UserIsMissing/Wet-Dry-Cycler/(list of files, cad)

Other CAD files:
pcb/pcb.gcode.3mf
pcb_v2/pcb/pcb.gcode.3mf
