UserIsMissing/Wet-Dry-Cycler/Cycletron/src/MOVEMENT.cpp

/**
 * @file    MOVEMENT.cpp
 * @brief   Movement module for stepper navigation using DRV8825 driver
 *
 * This module controls stepper motor movement across subsystems (e.g., heating,
 * mixing, extraction). It includes bumper detection, safe startup handling,
 * and DRV8825 stepper driver integration.
 *
 * Author: Cole Schreiner/Rafael Delwart
 * Date:   14 Apr 2025 adapted for ESP 13 May 2025
 */

#include <Arduino.h>
#include "MOVEMENT.h"
#include "globals.h"
#include "send_functions.h"


// === Constants ===
#define MOVEMENT_STEP_DELAY_US 1000 // Delay between microsteps
#define MOVEMENT_MAX_STEPS 10000 // Set your safety threshold here // needs to be found and changed

// === Global State ===
volatile bool movementFrontTriggered = false;
volatile bool movementBackTriggered = false;

// === Motor and Sensor Config ===
DRV8825_t movementMotor = {
    .step_pin = 6,
    .dir_pin = 7,
    .fault_pin = 15,
    .mode0_pin = 16,
    .mode1_pin = 17,
    .mode2_pin = 18,
    .enable_pin = 8};

BUMPER_t bumpers_m = {
    .front_bumper_pin = 3,
    .back_bumper_pin = 10,
};

enum MovementInitState {
  INIT_IDLE,
  INIT_MOVING_BACK,
  INIT_DONE
};

MovementInitState movementInitState = INIT_IDLE;

/**
 * @brief Initializes the movement motor and immediately disables it.
 *
 * Use this to ensure the motor is set up but not powered.
 *
 * .
 */
void MOVEMENT_InitAndDisable()
{
  DRV8825_Init(&movementMotor);
  Serial.println("[MOVEMENT] Motor initialized and disabled.");
}

/**
 * @brief Initializes the MOVEMENT system.
 *
 * Calibrates motor direction using bumper input and prepares the system
 * for safe directional control. It attempts to find the front bumper
 * and align to it before stopping.
 */
void MOVEMENT_Init()
{
    delay(500); // Delay for system stability

    DRV8825_Init(&movementMotor); // Initialize motor driver
    CheckBumpers();               // Read initial bumper state

    Serial.printf("Initial BUMPER_STATE: %d\n", BUMPER_STATE);

    // Ensure no movement if the back bumper is already pressed
    if (digitalRead(bumpers_m.back_bumper_pin) == HIGH)
    {
        Serial.println("[MOVEMENT] Back bumper already pressed. No movement required.");
        DRV8825_Disable(&movementMotor);
    }
    else
    {
        while (BUMPER_STATE != 2)
        {
            DRV8825_Move(&movementMotor, 1, DRV8825_BACKWARD, MOVEMENT_STEP_DELAY_US);
            CheckBumpers();
            
            // Yield control every few steps to prevent WebSocket timeouts during init
            static int initStepCount = 0;
            if (++initStepCount >= 10) {
              initStepCount = 0;
              yield(); // Allow WiFi/WebSocket processing
            }
        }
        DRV8825_Disable(&movementMotor);
    }

    Serial.println("[MOVEMENT] Initialization complete.");
}

/**
 * @brief Reads bumper interrupt flags and updates global BUMPER_STATE.
 * Now includes software debouncing to prevent false triggers.
 *
 * @return 1 = front bumper triggered, 2 = back bumper triggered, 0 = none
 */
int CheckBumpers()
{
  static unsigned long lastFrontTriggerTime = 0;
  static unsigned long lastBackTriggerTime = 0;
  unsigned long now = millis();
  
  if (movementFrontTriggered)
  {
    // Software debouncing: ignore triggers within 50ms of last trigger
    if (now - lastFrontTriggerTime > 50) {
      movementFrontTriggered = false; // Reset flag
      lastFrontTriggerTime = now;
      BUMPER_STATE = 1;
      Serial.println("[MOVEMENT] Front bumper triggered.");
      return 1;
    } else {
      movementFrontTriggered = false; // Reset flag but ignore trigger
    }
  }
  if (movementBackTriggered)
  {
    // Software debouncing: ignore triggers within 50ms of last trigger
    if (now - lastBackTriggerTime > 50) {
      movementBackTriggered = false; // Reset flag
      lastBackTriggerTime = now;
      BUMPER_STATE = 2;
      Serial.println("[MOVEMENT] Back bumper triggered.");
      return 2;
    } else {
      movementBackTriggered = false; // Reset flag but ignore trigger
    }
  }
  BUMPER_STATE = 0;
  return 0;
}

/**
 * @brief Moves motor based on bumper state.
 *
 * If front bumper is pressed, move backward until back is pressed.
 * If back bumper is pressed, move forward until front is pressed.
 * Movement stops immediately if target bumper is hit.
 * Updated to yield control for WebSocket stability.
 */
void MOVEMENT_Move_FORWARD()
{
  DRV8825_Set_Step_Mode(&movementMotor, DRV8825_FULL_STEP);
  CheckBumpers();
  int stepCount = 0;
  while (BUMPER_STATE != 1)
  {
    DRV8825_Move(&movementMotor, 1, DRV8825_FORWARD, MOVEMENT_STEP_DELAY_US);
    CheckBumpers();
    stepCount++;
    if (stepCount > MOVEMENT_MAX_STEPS) {
      MOVEMENT_Stop();
      currentState = SystemState::ERROR;
      sendSystemError(ERROR_MOVEMENT_MAX_STEPS_FORWARD);
      return;
    }
  }
  MOVEMENT_Stop();
}

void MOVEMENT_Move_BACKWARD()
{
  DRV8825_Set_Step_Mode(&movementMotor, DRV8825_FULL_STEP);
  CheckBumpers();
  int stepCount = 0;
  while (BUMPER_STATE != 2)
  {
    DRV8825_Move(&movementMotor, 1, DRV8825_BACKWARD, MOVEMENT_STEP_DELAY_US);
    CheckBumpers();
    stepCount++;
    if (stepCount > MOVEMENT_MAX_STEPS) {
      MOVEMENT_Stop();
      currentState = SystemState::ERROR;
      sendSystemError(ERROR_MOVEMENT_MAX_STEPS_BACKWARD);
      return;
    }
  }
  MOVEMENT_Stop();
}

/**
 * @brief Stops the motor by setting step pin LOW.
 */
void MOVEMENT_Stop()
{
  digitalWrite(movementMotor.step_pin, LOW);
  DRV8825_Disable(&movementMotor);
  Serial.println("[MOVEMENT] Motor stopped.");
}

/**
 * @brief Interrupt handler for front bumper trigger.
 *
 * Sets the global movementFrontTriggered flag to true.
 * Keep minimal to avoid watchdog resets and WebSocket issues.
 */
void IRAM_ATTR onMovementFrontLimit()
{
  movementFrontTriggered = true;
}

/**
 * @brief Interrupt handler for back bumper trigger.
 *
 * Sets a flag indicating the back bumper has been triggered.
 * Keep minimal to avoid watchdog resets and WebSocket issues.
 */
void IRAM_ATTR onMovementBackLimit()
{
  movementBackTriggered = true;
}

/**
 * @brief Configures GPIO pins for bumpers and sets up interrupts.
 *
 * Sets the front and back bumper pins as INPUT_PULLUP and attaches
 * interrupt handlers for both bumpers.
 *
 * Note: This version skips `detachInterrupt()` to avoid crashing if
 * the ISR service hasn't been initialized yet. It only attaches if
 * the pin is HIGH (i.e., unpressed).
 */
void MOVEMENT_ConfigureInterrupts()
{
  pinMode(bumpers_m.front_bumper_pin, INPUT_PULLDOWN);
  pinMode(bumpers_m.back_bumper_pin, INPUT_PULLDOWN);

  movementFrontTriggered = false;
  movementBackTriggered = false;

  attachInterrupt(digitalPinToInterrupt(bumpers_m.front_bumper_pin), onMovementFrontLimit, RISING);
  attachInterrupt(digitalPinToInterrupt(bumpers_m.back_bumper_pin), onMovementBackLimit, RISING);
}
/**
 * @brief Handles interrupts for front and back bumpers.
 *
 * Simplified version that just checks flags without detaching/reattaching interrupts
 * to prevent WebSocket timing issues.
 */
void MOVEMENT_HandleInterrupts()
{
  // The actual interrupt handling is now done in CheckBumpers() 
  // which provides software debouncing and is called from main loop
  // This function is kept for compatibility but could be removed
}
