UserIsMissing/Wet-Dry-Cycler/Cycletron/src/MIXING.cpp

/**
 * @file    MIXING.cpp
 * @brief   DC Motor control module using GPIO pins (Arduino/ESP32 compatible).
 *
 * Provides initialization and control functions for mixing motors.
 *
 * @author  Rafael Delwart
 * @date    25 Feb 2025 adapted for ESP 13 May 2025
 */

 #include <Arduino.h>
 #include "MIXING.h"
 

//  #define TESTING_MIXING

 // === CONFIG ===
 #define MIX1_GPIO 11
 #define MIX2_GPIO 12
 #define MIX3_GPIO 13  
 
 // Define motor GPIOs in an array for batch operations
 static const uint8_t motorPins[] = {MIX1_GPIO, MIX2_GPIO, MIX3_GPIO};
 static const int NUM_MOTORS = sizeof(motorPins) / sizeof(motorPins[0]);
 
 // === API IMPLEMENTATION ===
 
 /**
  * @brief Initializes all mixing motor GPIOs as OUTPUT and sets them LOW.
  */
 void MIXING_Init() {
   for (int i = 0; i < NUM_MOTORS; i++) {
     pinMode(motorPins[i], OUTPUT);
     digitalWrite(motorPins[i], LOW);  // Motors off by default
   }
   Serial.println("[MIXING] All motors initialized and set to OFF");
 }
 
 /**
  * @brief Turns ON the motor connected to the given GPIO pin.
  * @param pin GPIO pin number
  */
 void MIXING_Motor_OnPin(uint8_t pin) {
   digitalWrite(pin, HIGH);
 }
 
 /**
  * @brief Turns OFF the motor connected to the given GPIO pin.
  * @param pin GPIO pin number
  */
 void MIXING_Motor_OffPin(uint8_t pin) {
   digitalWrite(pin, LOW);
 }
 
 /**
  * @brief Turns ON all defined motors.
  */
 void MIXING_AllMotors_On() {
   for (int i = 0; i < NUM_MOTORS; i++) {
     digitalWrite(motorPins[i], HIGH);
   }
 }
 
 /**
  * @brief Turns OFF all defined motors.
  */
 void MIXING_AllMotors_Off() {
   for (int i = 0; i < NUM_MOTORS; i++) {
     digitalWrite(motorPins[i], LOW);
   }
 }

// === TEST LOOP ===
// This section is for testing the mixing motors.
#ifdef TESTING_MIXING

void setup() {
  Serial.begin(115200);
  MIXING_Init();
}

void loop() {
  // Step through each motor
  for (int i = 0; i < NUM_MOTORS; i++) {
    Serial.printf("[TEST] Turning ON motor %d (GPIO %d)\n", i + 1, motorPins[i]);
    MIXING_Motor_OnPin(motorPins[i]);
    delay(10000); // ON for 10 seconds

    Serial.printf("[TEST] Turning OFF motor %d (GPIO %d)\n", i + 1, motorPins[i]);
    MIXING_Motor_OffPin(motorPins[i]);
    delay(3000);  // OFF for 3 seconds
  }

  // All motors ON
  Serial.println("[TEST] Turning ALL motors ON");
  MIXING_AllMotors_On();
  delay(20000);

  // All motors OFF
  Serial.println("[TEST] Turning ALL motors OFF");
  MIXING_AllMotors_Off();
  delay(5000);
}

#endif // TESTING_MIXING
