UserIsMissing/Wet-Dry-Cycler/Cycletron/src/REHYDRATION.h

/**
 * @file    REHYDRATION.h
 * @brief   Syringe pump control interface for RNA fluid rehydration
 *
 * This header declares the control functions for a stepper motor
 * used to precisely dispense and retract fluid via a syringe pump.
 * It uses a DRV8825 stepper motor driver to move the plunger and
 * convert microliter requests into accurate step commands.
 *
 * Designed for use in wet-dry cycling systems for RNA research.
 *
 * Author: Rafael Delwart
 * Date:   20 Apr 2025 adapted for ESP 13 May 2025
 */

#ifndef REHYDRATION_H
#define REHYDRATION_H

#include <Arduino.h>
#include "DRV8825.h"

// === Global State Flag ===
/**
 * @brief Global variable indicating bumper contact:
 * - 0 = no bumper pressed
 * - 1 = front bumper pressed
 * - 2 = back bumper pressed
 */
extern int BUMPER_STATE;
// === SYRINGE PUMP Max Steps ===
#define MAX_SYRINGE_STEPS 159251  // or a more realistic value based on your hardware


// === Syringe & Motion Parameters ===
#define STEPPER_STEPS_PER_REV 200 // Full steps per revolution of stepper motor
#define MICROSTEPPING 16          // Microstepping mode (e.g., 1/16 step)
#define LEADSCREW_TPI 20          // Threads per inch of leadscrew
#define SYRINGE_DIAMETER_IN 1.0   // Syringe barrel inner diameter in inches

// === Conversion Factors ===
#define TOTAL_STEPS_PER_REV (STEPPER_STEPS_PER_REV * MICROSTEPPING)
#define LEADSCREW_TRAVEL_IN_PER_REV (1.0 / LEADSCREW_TPI)
#define STEP_TRAVEL_IN (LEADSCREW_TRAVEL_IN_PER_REV / TOTAL_STEPS_PER_REV)
#define INCH3_TO_UL 16387.064 // Conversion factor from in³ to microliters

/**
 * @brief Calculates how many microliters are moved per motor step.
 *
 * This function computes the volume displaced by one step of the leadscrew-driven
 * syringe pump based on the cross-sectional area of the syringe and the travel
 * distance per motor step.
 *
 * @param syringeDiameterInches Inner diameter of the syringe barrel (in inches).
 * @return Volume in microliters (µL) moved by one motor step.
 */
float calculate_uL_per_step(float syringeDiameterInches);


/**
 * @brief Initializes the syringe pump motor and immediately disables it.
 *
 * Use this to ensure the motor is set up but not powered.
 *
 * @param syringeDiameterInches Syringe inner diameter in inches.
 */
void Rehydration_InitAndDisable();


/**
 * @brief Initializes the syringe pump stepper motor.
 *
 * This sets up the DRV8825 driver pins, applies the default microstepping mode,
 * and prints calibration data including the volume of fluid dispensed per motor step.
 * Call this once during system setup.
 *
 * @param syringeDiameterInches Syringe diameter in inches (e.g., 0.25 for 1/4 inch)
 */
void Rehydration_Init(float syringeDiameterInches);

/**
 * @brief Dispenses a specific volume of liquid in microliters by pushing the plunger forward.
 *
 * Converts the desired microliters to motor steps based on syringe and leadscrew dimensions,
 * and moves the motor forward (push) at a controlled speed to ensure accurate fluid delivery.
 *
 * @param uL Volume of fluid to dispense, in microliters.
 * @param syringeDiameterInches Syringe diameter in inches (e.g., 0.25 for 1/4 inch)
 */
void Rehydration_Push(uint32_t uL, float syringeDiameterInches);

/**
 * @brief Retracts the syringe plunger to draw fluid or prime the system.
 *
 * Similar to Rehydration_Push(), but moves in reverse to create suction.
 * Useful for loading liquid into the syringe or preparing it for operation.
 *
 * @param uL Volume of fluid to draw back, in microliters.
 * @param syringeDiameterInches Syringe diameter in inches (e.g., 0.25 for 1/4 inch)
 */
void Rehydration_Pull(uint32_t uL, float syringeDiameterInches);

/**
 * @brief Disables the stepper motor to stop motion and reduce power consumption.
 *
 * This function cuts power to the DRV8825 driver, halting the motor and preventing
 * unnecessary heating or energy drain. It should be called after movement is complete.
 */
void Rehydration_Stop();

// BUMPER HANDLING

/**
 * @brief Interrupt handler for front bumper trigger.
 *
 * Sets a flag indicating the front bumper has been triggered.
 */
void IRAM_ATTR onRehydrationFrontLimit();
/**
 * @brief Interrupt handler for back bumper trigger.
 *
 * Sets a flag indicating the back bumper has been triggered.
 */
void IRAM_ATTR onRehydrationBackLimit();

/**
 * @brief Configures GPIO pins for front and back bumpers.
 *
 * Sets the specified pins as input with pull-up resistors and attaches
 * interrupt handlers for detecting bumper presses.
 *
 */
void REHYDRATION_ConfigureInterrupts();
/**
 * @brief Handles interrupts for front and back bumpers.
 *
 * Handles the state of the bumpers and stops the rehydration process
 * if either bumper is triggered. This function should be called in the
 * main loop to check for bumper events.
 *
 */

void REHYDRATION_HandleInterrupts();


/**
 * @brief Moves backward until the back bumper is hit.
 */
void Rehydration_BackUntilBumper();


int R_CheckBumpers();



/**
 * @brief Performs calibration test to measure syringe travel range
 * @return Total number of 1/16th steps between bumpers
 */
uint32_t Rehydration_CalibrationTest();


#endif // REHYDRATION_H
