UserIsMissing/Wet-Dry-Cycler/(commit log)

2025-01-23 Stepper Motor running at half steps using the ECE167 library for the STM32
2025-02-20 Fixing Heating Module
2025-02-25 Initial heating module finished, test still need to be made
2025-02-27 Adding Pin details and renaming pins
2025-03-02 Update MIXING.c pin identifier
2025-03-02 Update HEATING.c pin identifier
2025-03-16 Cleaned Up Mixing Code, and Changed heating to work with voltage divider IC
2025-04-09 testing stepper driver using pwms
2025-04-11 Added Rehydration_DRV8825 code(can be copied and pins changed for movement system aswell.) Also changed GPIO h/c to add more gpio pins for the DRV8825 control. Motor uses 6 gpios.
2025-04-11 Updated DRV8825 Library to be universal and work with multiple motors, tested code and other small changes everything appears to work(still need to test fault line)
2025-04-17 cant printf
2025-04-20 Added an enable pin to the DRV8825 code in order to stop current draw when the motor isnt moving. Added for DRV example coded aswell as the Movement library
2025-04-20 Changed the heating system to use the BETA method instead, far more reliable and accurate. Seems to work great!
2025-04-22 Enable pin working. going to add ISR now for bumpers
2025-04-23 fixed syntax. need to test ISR
    [MOVEMENT.h]
2025-04-23 changed syringe diameter
2025-04-23 Changed mixing/heating pins and updated some code
2025-04-23 Fixing mixing pins and heatings pins
    [MIXING.h]
2025-04-23 Fixing merge issues and GPIO file problems
    [HEATING.h]
2025-04-24 fixed state machine? still working on ISR testing
    [Board.c]
2025-04-24 ISR WORKS! needed to add // Add manual fallback EXTI->FTSR |= GPIO_PIN_8; // Ensure falling edge is enabled to board.c
2025-06-04 Merging Cole And Rafael Branches to main
    [12V Power Supply.kicad_sch, BOM.csv, Heating_controller.kicad_sch, Regulator.kicad_sch, VoltageDivider.kicad_sch, Wet_Dry Cycling.kicad_pcb, Wet_Dry Cycling.kicad_sch, mixing_control.kicad_sch]
2025-06-04 fixing accidentaly push to main and rechanging the websocket so that it works on mac and windows
    [main.cpp]
2025-06-04 Reset esp from frontend
    [handle_functions.cpp]
2025-06-06 ESP RECOVERY WORKS ON PC - Replaced File I/O with SQLite Database
    [handle_functions.cpp]
2025-06-08 cleaning up state machine and fixing minor bugs, also syringe refill works still needs to be refined
    [DRV8825.cpp, MOVEMENT.cpp, REHYDRATION.cpp, REHYDRATION.h, globals.cpp, globals.h, handle_functions.cpp, handle_functions.h]
2025-06-26 Add error hadnling and cleanup
    [DRV8825.cpp, MOVEMENT.cpp, MOVEMENT.h, REHYDRATION.cpp, globals.h, main.cpp, send_functions.cpp, send_functions.h]
2025-07-03 Rehydration Test 2 for syringe calibration
2025-07-04 fixed syringe progress to ready or not, parameters allow 0 to be typed, heating in minutes
2025-07-04 "Cycle Progress" changed to "Current State Progress"
